Robson-Filgueiras/GeoTank-LaserScan/(commit log)

2026-09-27 firmware: motor async (AccelStepper), laser em streaming (pollLaser), Horizon Level com malha fechada de ângulo real (MPU6050), touch com debounce por tempo
    Estado intermediário (V018). Pendências conhecidas, não resolvidas neste commit:
    - executeScanStep() foi esvaziado; nada no loop() emite moveTo() para a varredura radial em si (startScan/loop nao movem o motor do ponto da quina ate o centro)
    - captureQuina() nao resincroniza stepper.setCurrentPosition() com o angulo real do IMU apos o reposicionamento manual (motor livre); o contador de passos fica desatualizado
    - a leitura de theta durante a varredura (loop, bloco scanRunning) usa stepper.currentPosition(), nao o IMU - contraria a d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
2026-11-08 fix(kinematics): implementa V057 com compensação radial X/Z e auto-busca rigorosa API 650
2026-11-09 fix(calibration): update V058 90-deg horizon reference to 88.30 deg (-0.65 deg / -25 mm at 2.15 m)
2026-11-09 fix(laser): enforce strict M01 BCD decoding, default to 0x21 Cont (3.2 Hz) and rearm immediately after Fast Slew
2026-11-09 fix(vertex): calibrate vertex target to 73.46 deg (-4.5mm trim) with anti-backlash upward approach (3mm on floor)
