Robson-Filgueiras/GeoTank-LaserScan/(notices)

Notices in the files:
sketch_V058/sketch_V058.ino:
Copyright (C) 2026 Robson Filgueiras.
This program is free software: you can redistribute it and/or modify
it under the terms of the GNU General Public License as published by
the Free Software Foundation, either version 3 of the License, or
(at your option) any later version.
